ke0ff/IC901_ToneUnit_clone/HW/ToneUnit_pgm_cable.JPG

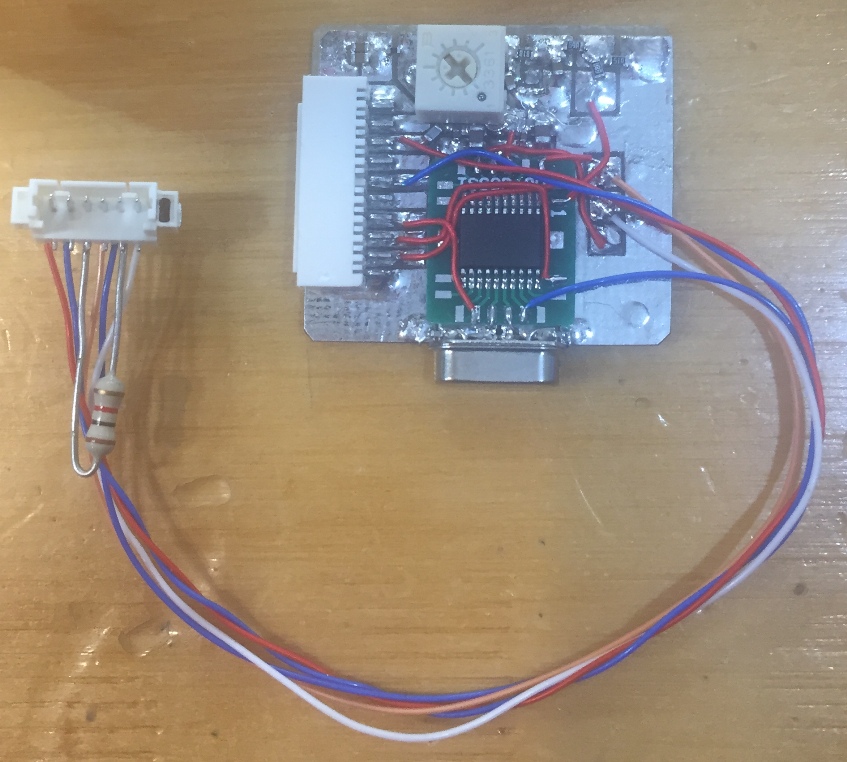
HW/ToneUnit_pgm_cable.JPG
