ke0ff/IC901_ToneUnit_clone/ToneUnit_ICD.pdf

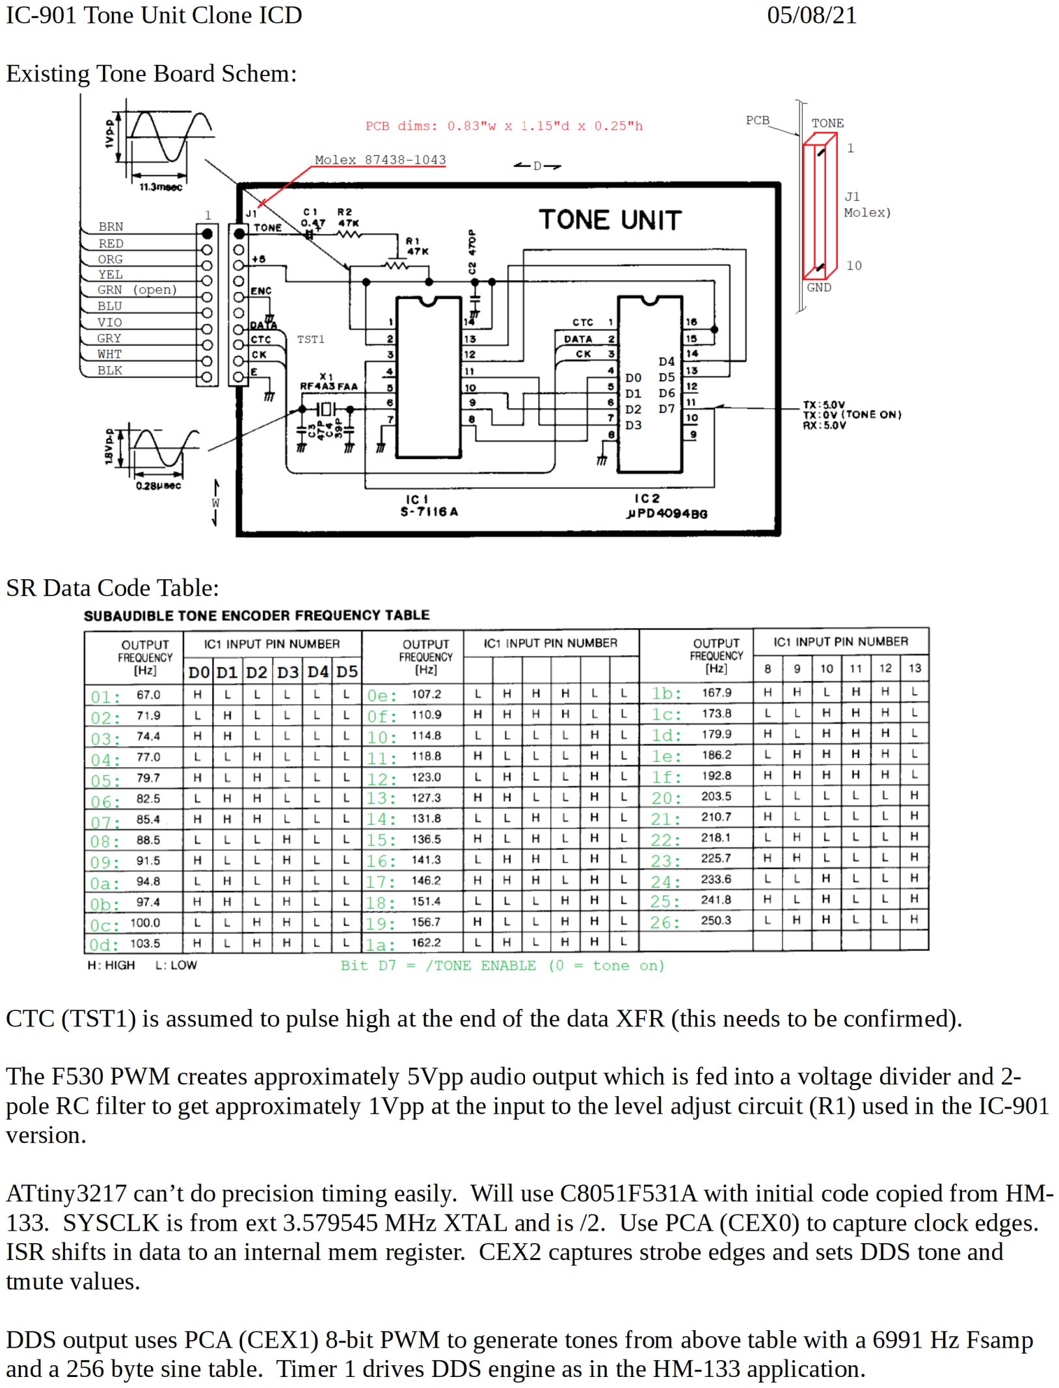
[picture p2: page 1]

CD4094 uses rising edge clock. Data shifts msb first. Data latches when strobe is high.

IPL with no tone (delF1 = 0 and tmute = 1) until enabled via SPI message.

C8051F531 I/O map:

P0.0: Vref (n/c)
P0.1: CK (SPI CLK), input (CEX0) P0.2: PWM, output (CEX1)
P0.3: CTC (STB), input (CEX2) P0.4: UART TX (n/c)
P0.5: UART RX (n/c)
P0.7: X1 (xtal)
P1.0: X2 (xtal)
P1.1: DATA (MOSI), input (GPIO)
P1.6: Fsamp out (n/c) (GPIO) {edges toggle at sample rate}

All others = not used, set to push-pull output.
