ke0ff/IC901_ToneUnit_clone/HW/RevA_DATA/IC901_TU_BOM.xls

Quantity | Designator | Comment | Description | MPN | MFR | Footprint | LibRef | DNP
2 | C1, C11 | 1.0uF | CAP, CER, 0805, 1.0uF, 25V | CL21B105KBFNNNF | Samsung | 0805 | CAP 0805
5 | C2, C6, C8, C12, C13 | 0.1uF | CAP, CER, 0402, 0.1uF, 50V | 04025C104KAT2A | AVX | 0402 | CAP CER
2 | C3, C4 | 22pF | CAP, MLCC, NPO, 1%, 0402, 50V, 22pF | GCM1555C1H220FA16D | Murata | 0402 | CAP 0805
2 | C5, C7 | 4.7uF | CAP, CER, 0805, 4.7uF, 10V | C2012X7R1A475K125AC | TDK | 0805 | CAP 0805
2 | C9, Ce1 | 0.047uF | CAP, CER, NPO, 0805, 50V, 47nF | CC1206JKNPO9BN473 | Yageo | 1206 | CAP 0805
2 | C10, Ce2 | 4700pF | CAP, CER, 0805, NPO, 50V, 4700pF | 0805N472J500CT | Walsin | 0805 | CAP 0805
1 | C14 | 1000pF | CAP, CER, 0402, 50V, 1000pF | CC0402JRNPO9BN102 | Yageo | 0402 | CAP CER
1 | J1 | TONE | CON, 10POS, 1.5mm, RTANG, SMD | 87438-1043 | Molex | MOLEX_1.5mm_SMD_10POS | CON10
1 | P1 | PGM | CON, 6POS, 1.25MM, SMD | 53398-0671 | Molex | CON_1.25MM_6P | HEADER-6-PIN-RT-ANG
3 | R1, R2, R3 | 1.00K | RES, CHP, 0402, 1%, 1K | RC0402FR-071KL | Yageo | 0402 | R0805
1 | R4 | 100K | RES, CHP, 0402, 1%, 100K | RC0402FR-07100KL | Yageo | 0402 | R0805 | DNP
1 | R5 | 499 | RES, CHP, 0402, 1%, 499 | RC0402FR-07499RL | Yageo | 0402 | R0805
1 | R6 | 909 | RES, CHP, 0402, 1%, 909 | RC0402FR-07909RL | Yageo | 0402 | R0805
1 | R7 | 13.7K | RES, CHP, 0402, 1%, 13.7K | RC0402FR-0713K7L | Yageo | 0402 | R0805
1 | R8 | 47K | RES, CHP, 0402, 1%, 47K | RC0402FR-0747KL | Yageo | 0402 | R0805
1 | R9 | 10 | RES, CHP, 0402, 1%, 10.0 | RC1206FR-7W10RL | Yageo | 1206 | R0805
1 | R10 | 330 | RES, CHP, 0402, 1%, 330 | RC0402FR-07330RL | Yageo | 0402 | R0805
1 | R12 | 10.0M | RES, CHP, 0402, 1%, 10.0M | RC0402FR-0710ML | Yageo | 0402 | R0805 | DNP
1 | U1 | C8051F530 | IC, MCU, 8051, F531 | C8051F531-C-IT | SiLabs | TSSOP-20 | C8051F531
1 | VR1 | 47K | RES, VAR, MICRO, SMD, 1T, 47K | 3313X-1-503E | Bourns | POT_3313 | RESISTOR VAR
1 | Y1 | 3.5795M | CRSTL, QRTZ, HC49U, <=50ppm | ABLSG-3.579545MHZ-D2Y-T | Abracon | XTAL_AT49_SMD | CRYSTAL-2PIN
