ke0ff/IC901_ToneUnit_clone/ToneUnit_schem.pdf

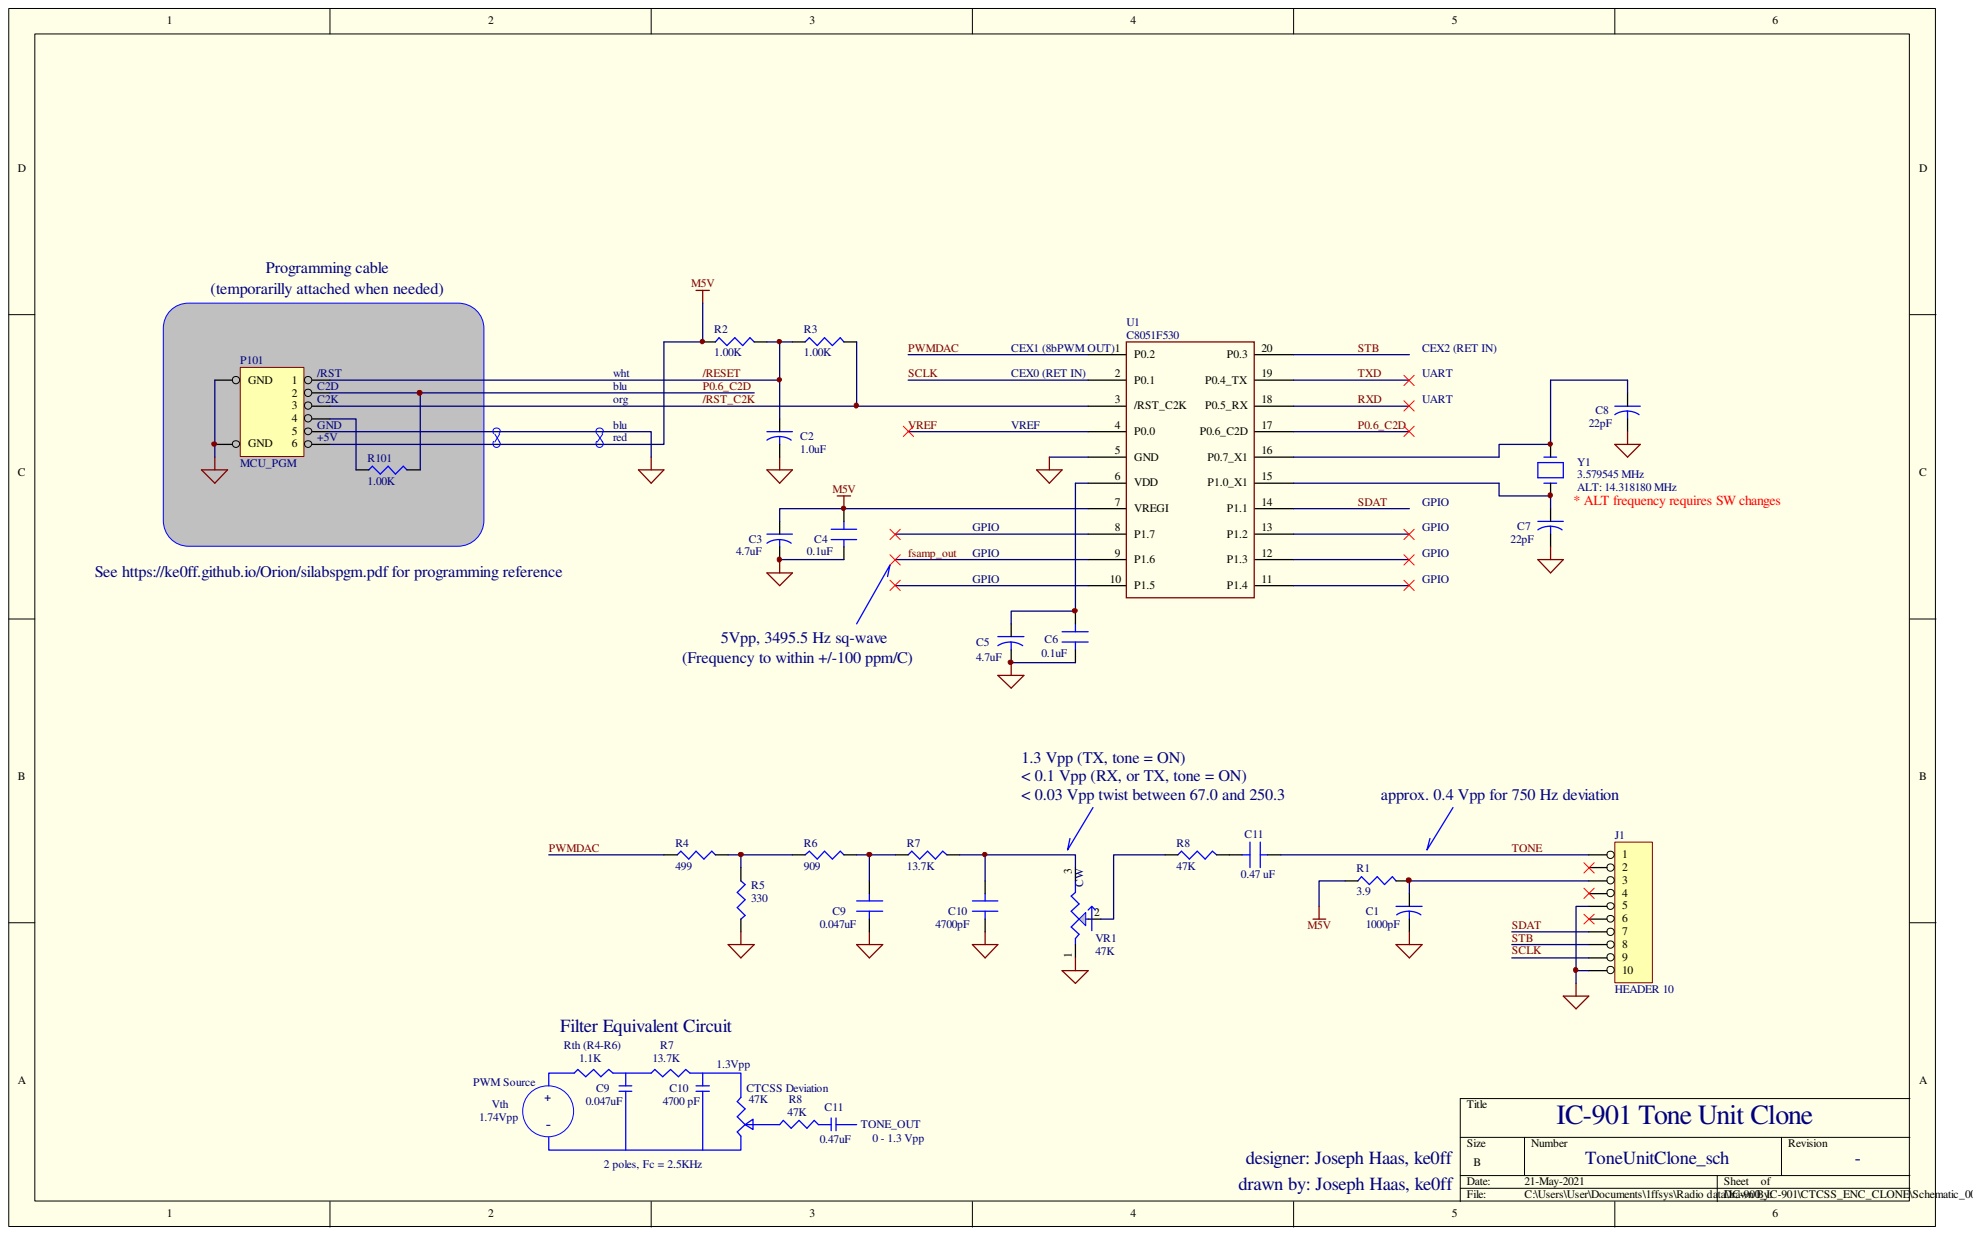
[picture p4: page 1]

(temporarilly attached when needed)

3.579545 MHz
ALT: 14.318180 MHz
* ALT frequency requires SW changes

5Vpp, 3495.5 Hz sq-wave
(Frequency to within +/-100 ppm/C)

1.3 Vpp (TX, tone = ON)
< 0.1 Vpp (RX, or TX, tone = ON)
< 0.03 Vpp twist between 67.0 and 250.3

approx. 0.4 Vpp for 750 Hz deviation

IC-901 Tone Unit Clone

designer: Joseph Haas, ke0ff
drawn by: Joseph Haas, ke0ff
