ke0ff/IC901_ToneUnit_clone/HW/RevA_DATA/IC901_TU_schem.PDF

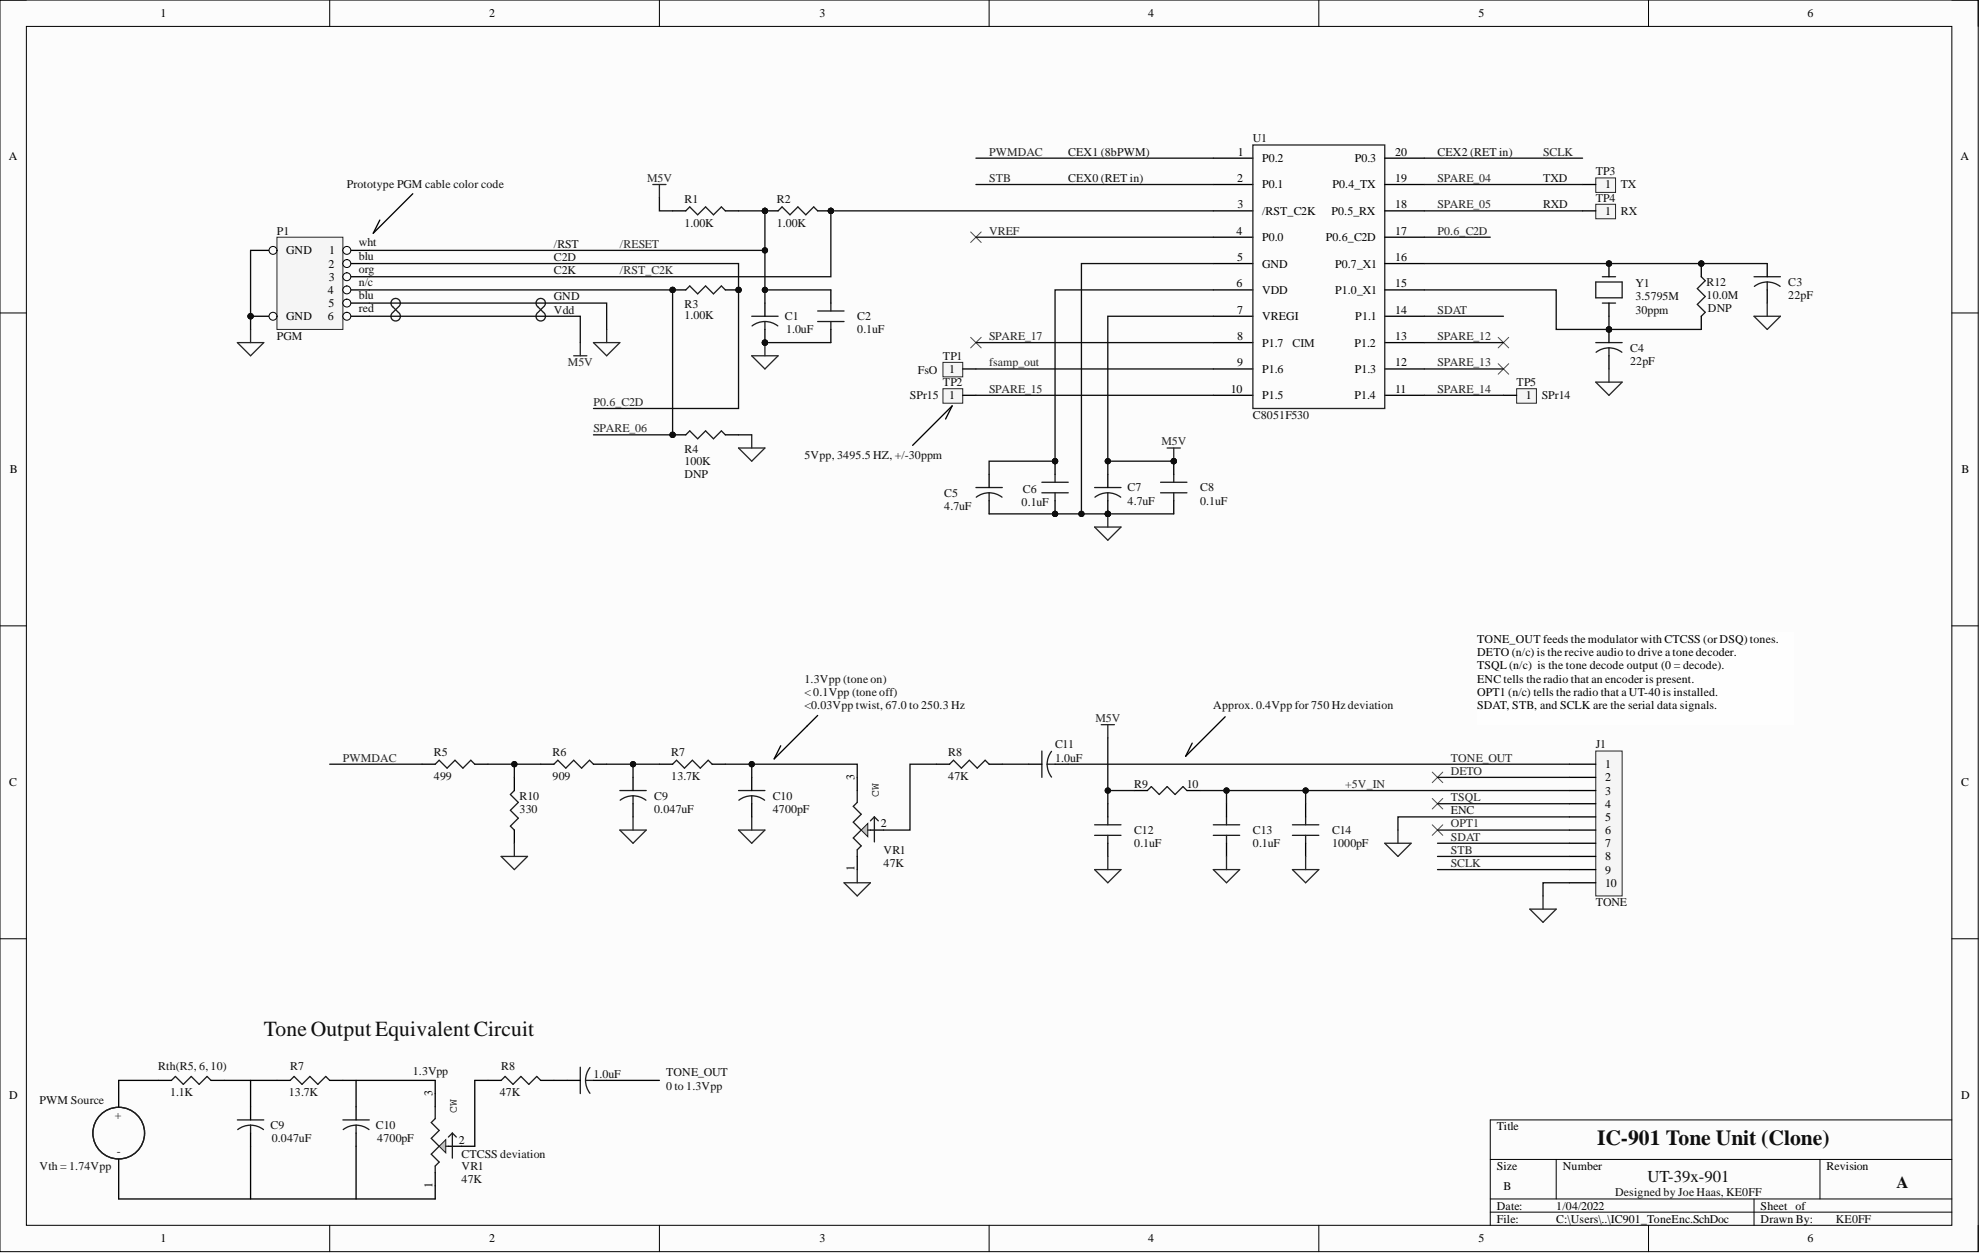
[picture p5: page 1]

Prototype PGM cable color code

1.00K /RST /RESET | 1.00K | VREF | P0.0 4 GND 5

blu | C2D

red | Vdd

VREGI 7

SPARE_15

TONE_OUT feeds the modulator with CTCSS (or DSQ) tones.
DETO (n/c) is the recive audio to drive a tone decoder.
TSQL (n/c) is the tone decode output (0 = decode).
ENC tells the radio that an encoder is present.
OPT1 (n/c) tells the radio that a UT-40 is installed.
SDAT, STB, and SCLK are the serial data signals.

Approx. 0.4Vpp for 750 Hz deviation

Tone Output Equivalent Circuit

IC-901 Tone Unit (Clone)

Designed by Joe Haas, KE0FF
