ke0ff/IC901_ToneUnit_clone/HW/RevA_DATA/IC901_TU_Drill Guide.PDF

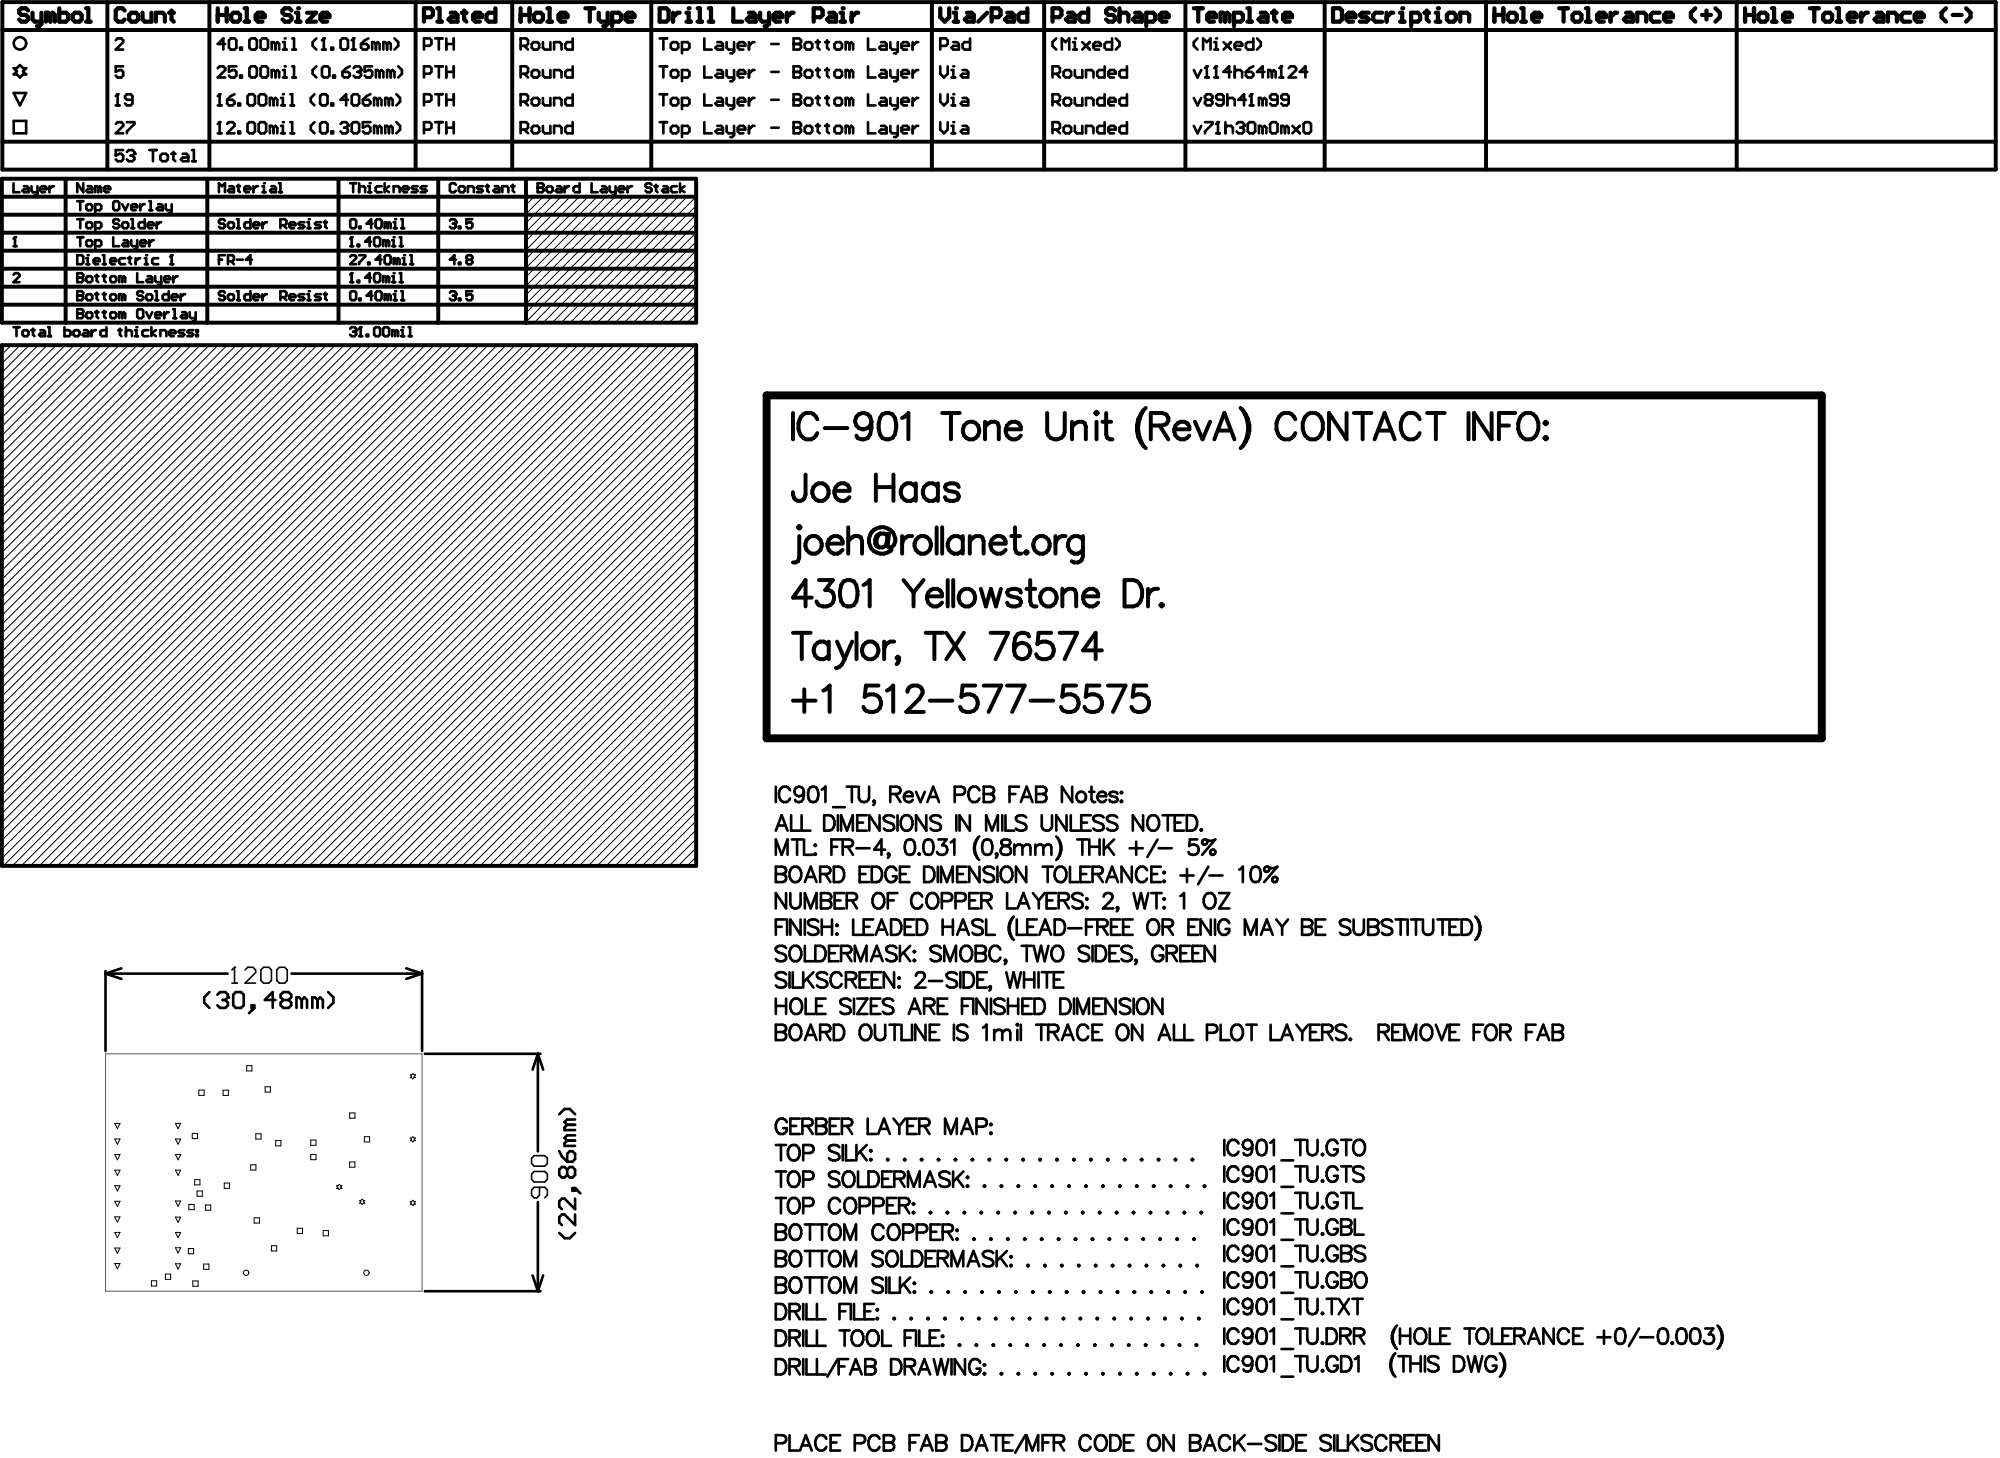
[picture p6: page 1]

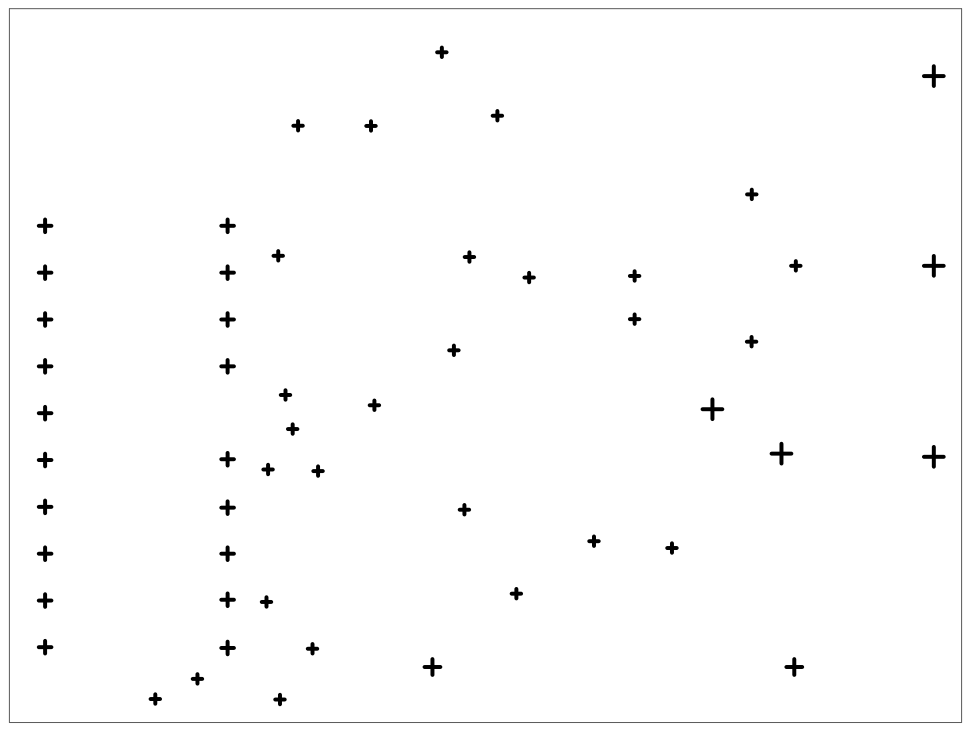
[picture p7: page 2]
