ke0ff/IC901_ToneUnit_clone/(commit log)

2021-05-09 Add files via upload
    Added spreadsheet to design repo
    [dds_calc.xls]
2021-05-10 Add files via upload
    Updated filter circuit and corrected typos
2021-05-22 Add files via upload
    Reference data commit.
    [DPL_calc.xlsx]
2021-05-26 Add files via upload
    Improved spreadsheet capability and useability.
    [dds_calc.xls]
2022-01-05 RevA PCB commit
    PCB FAB, schem, and BOM data for the revA ToneClone design.
    [IC901_TU_BOM.xls]
